andre-i/mini_weather/espSensors/notes.txt

08.02.18

1)  сменил датчикаи , теперь дс - эталонный для температур ,а показания даю с бмп-шки.
