andre-i/mini_weather/pict/forecast_ru.png

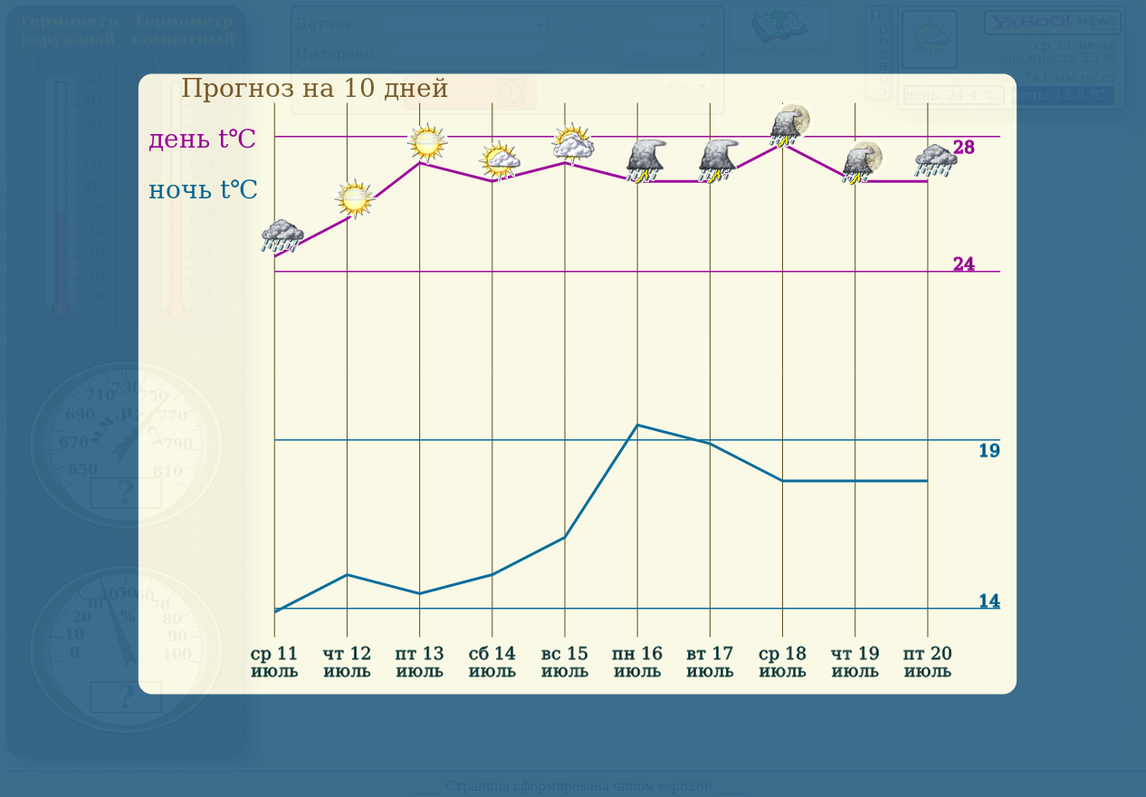
pict/forecast_ru.png
