andre-i/mini_weather/pict/IMG_20180507_144934.jpg

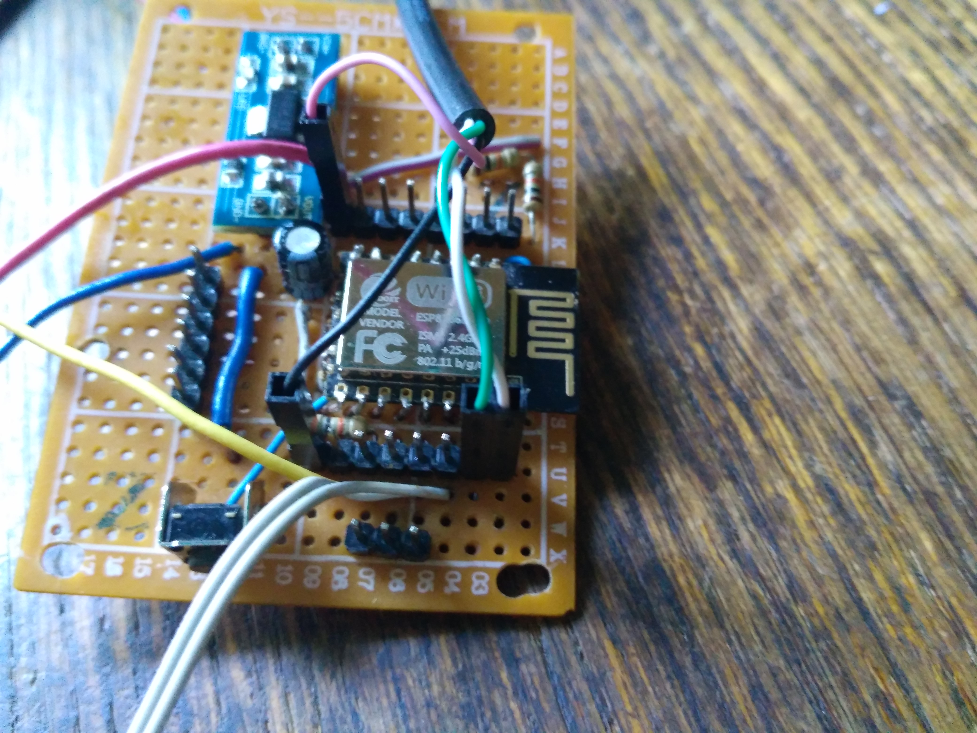
pict/IMG_20180507_144934.jpg
