andre-i/mini_weather/pict/view_ru.png

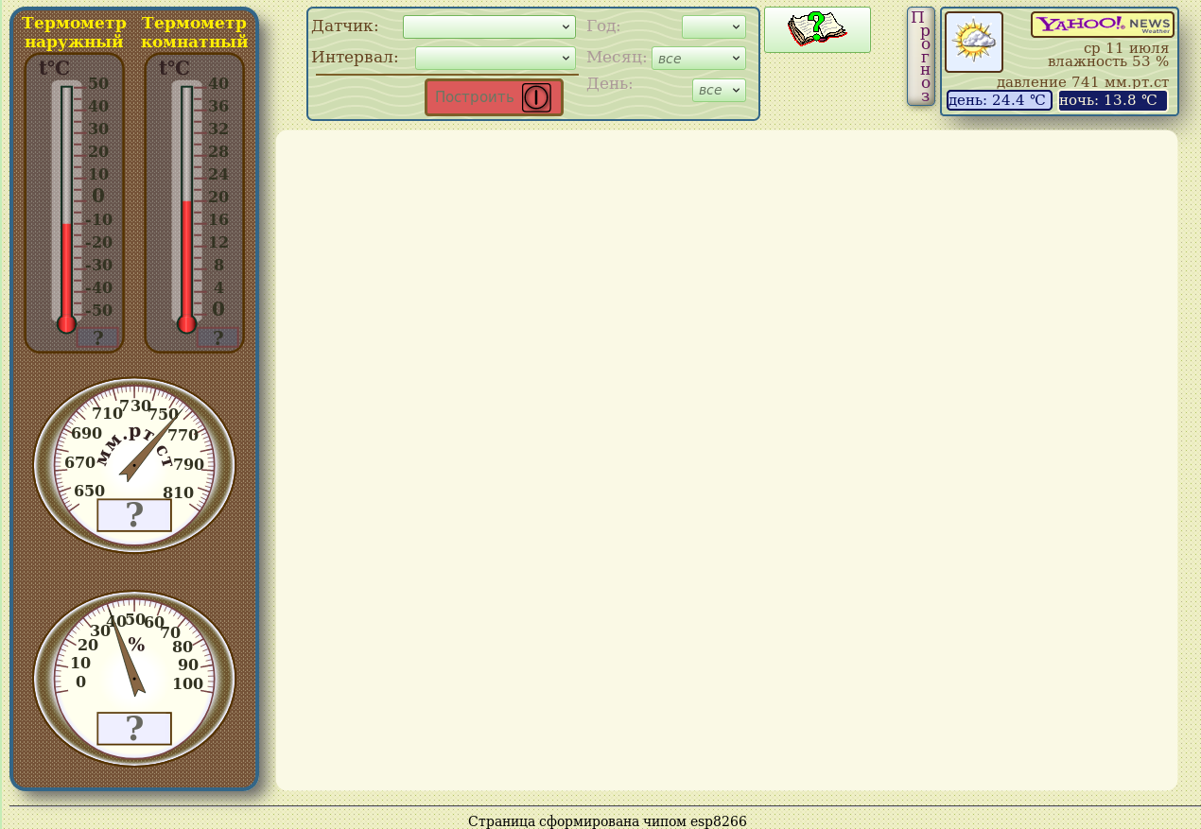
pict/view_ru.png
