andre-i/mini_weather/espSensors/Sensors.cpp

#include "Sensors.h"

extern bool LOG;

//  =========== PUBLIC ==================

/** set class variables for sensors */
Sensors::Sensors(uint8_t wBus, int dhtType) {
  for (int i = 0; i < maxCounterNumber ; i++) {
    allIn[i] = allOut[i] = allBaro[i] = allHumid[i] = "-100";
  }
  tIn = tOut = baro = humid = DEVICE_DISCONNECTED_C;
  mediaIn = mediaOut = mediaBaro = mediaHumid = 0;
  oneWire = new OneWire(wBus);
  dht = new DHT(wBus, dhtType);
  bme = new Adafruit_BMP280();
}

/** Try prepare sensors  on success return 0*/
int Sensors::init(Util *u) {
  int exitCode = 0;
  maxCounterNumber = REQUEST_COUNT - 1;
  // ds18b20
  dsMode = u->getDS18B20Mode();
  if (dsMode)sensors = new DallasTemperature(oneWire);
  if (dsMode)sensors->begin();
  if (dsMode)Serial.println("Init ds18b20");
  // DHT
  dht->begin();
  delay(1000);
  Serial.print("Start DHT .");
  delay(1000);
  Serial.print(".");
  delay(1000);
  Serial.println(".  ");
  if(!checkDHT()){
    exitCode += 1;
  }
  //  BMP 280
  if (!bme->begin(0x76)) {
    Serial.println("\n\tERROR BMP280  !");
    exitCode +=2;
  } else {
    if (LOG)Serial.println("Init BMP280");
  }
  return exitCode;
}

//  request sensors, compute media , fill arrays of values

// ds 18B20 purpose comparison with themperature other sensors
void Sensors::readDS18B20() {
  if (dsMode) {
    //if (++lastDS18B20 > maxCounterNumber)lastDS18B20 = 0;
    sensors->requestTemperatures(); // Send the command to get temperatures
    dsTemp = (int)(sensors->getTempCByIndex(0) * 10 + 0.5) / 10;
    Serial.print("DS18B20 t=");
    Serial.println(dsTemp);
  }
}

bool Sensors::checkDHT(){
  int t =  (int)(dht->readTemperature() + 0.5);
  int h = (int)(dht->readHumidity() + 0.5);
  if(isnan(t) || isnan(h))return false;
  if(h < 0 || h > 100) return false;
  if(t < -4 || t > 100) return false;
  return true;
}

void Sensors::readDHT() {
  if (++lastDHT > maxCounterNumber)lastDHT = 0;
  tIn = (int)(dht->readTemperature() + 0.5) + shiftThemperatureDHT;
  humid = (int)(dht->readHumidity() + 0.5);
  if ( isnan(tIn) || isnan(humid)) {
    if (LOG)Serial.println("Can`t read DHT sensor data");
    tIn = humid = DEVICE_DISCONNECTED_C;
  }
  allIn[lastDHT] = String(tIn);
  allHumid[lastDHT] = String(humid);
  if (lastDHT == 0) {
    mediaIn = tIn;
    mediaHumid = humid;
  } else {
    mediaIn = (int)((mediaIn + tIn) / 2 + 0.5);
    mediaHumid = (int) ((mediaHumid + humid) / 2 + 0.5);
  }
}

void Sensors::readBMP280() {
  if (++lastBMP280 > maxCounterNumber) lastBMP280 = 0;
  baro = (int)(bme->readPressure() / 133.32239F + 0.5);
  allBaro[lastBMP280] = String(baro);
  if (lastBMP280 == 0)mediaBaro = baro;
  else mediaBaro = (int)((mediaBaro + baro) / 2 + 0.5);
  tOut = bme->readTemperature() + shiftThemperatureBMP;
  allOut[lastBMP280] = String(tOut);
  if (lastBMP280 == 0)mediaOut = tOut;
  else mediaOut = (int)((mediaOut + tOut) / 2 + 0.5);

}



//  get sensors values
void Sensors::makeCurrentToJSON() {
  currentInJSON = String("{ \"tIn\":") + String(tIn) + String(", \"tOut\":") + String(tOut) +
                  String(", \"baro\":") + String(baro) + String(", \"humid\":") + String(humid) + String(" }");
}

String Sensors::getCurrentAsJSON() {
  if (LOG) {
    Serial.print("\"getCurrentAsJSON\": ");
    Serial.print(currentInJSON);
    String res = " [ BMP280 t= " + String(tOut);
    if(dsMode) res += " Dallas t= " + String(dsTemp);
    res += " ]";
    Serial.println(res);
  }
  return currentInJSON;
}


String Sensors::getLastAsJSON(String dataType) {
  String *type;
  int len = maxCounterNumber, last ;
  String res = "{ \"" + dataType + "\" : [ ";
  if (dataType == T_IN ) {
    type = allIn;
    last = lastDHT;
  }
  else if (dataType == HUMID) {
    type = allHumid;
    last = lastDHT;
  }
  else if (dataType == T_OUT) {
    type = allOut;
    last = lastBMP280;
  }
  else if (dataType == BARO) {
    type = allBaro;
    last = lastBMP280;
  }
  else {
    res = (String("{ \"ERROR\":[\"Not have sensors for ") + String(dataType) + String(", \" \" ], \"last\":0 }")) ;
    len = 0;
  }
  if ( len > 0 ) {
    for ( int i = 0; i < len; i++) {
      res += *(type + i) + ", ";
    }
    res += *(type + len) + "], \"last\": " + String(last) + " }";
  }
  if (LOG) {
    Serial.print("\"getLastAsJSON return: ");
    Serial.println(res);
    Serial.println("------------\n");
  }
  return res;
}

//
// get sensors values as Integer
//
int  Sensors::getT_In(){
  return tIn;
}
int  Sensors::getT_Out(){
  return tOut;
}
int  Sensors::getHumid(){
  return humid;
}
int  Sensors::getBaro(){
  return baro;
}

int Sensors::getMedia(String dataType) {
  if (dataType == T_IN)return mediaIn;
  if (dataType == T_OUT)return mediaOut;
  if (dataType == BARO) return mediaBaro;
  if (dataType == HUMID)return mediaHumid;
  return  DEVICE_DISCONNECTED_C;
}

void Sensors::getState(){
  Serial.println("Call Sensors::getState()");
}

// ============= PRIVATE ===================
