andre-i/mini_weather/espSensors/SerialHandler.cpp

#include "SerialHandler.h"

extern bool LOG;
extern bool DEBUG;

SerialHandler ::SerialHandler(Util *u) {
  util = u;
}

void SerialHandler::setFSstate( bool fsState) {
  isFS = fsState;
}

void SerialHandler::showFile(char answ[]) {
  String fName = answ;
  fName = fName.substring(2, fName.length());
  File file = SPIFFS.open(fName.c_str(), "r");
  if (!file) {
    Serial.print("Can`t open file: ");
    Serial.println(fName);
    Dir dir = SPIFFS.openDir(fName.c_str());
    String content = "";
    while (dir.next()) {
      content += "\t" + dir.fileName() + "\t";
      File f = dir.openFile("r");
      content += String(f.size()) + "\n";
      f.close();
      delay(60);
    }
    if (content.length() > 1) {
      Serial.println("File is directory it contains:");
      Serial.println(content);
    }
    return;
  } else {
    Serial.println("\t______ file content : ____");
    while (file.available())Serial.write(file.read());
    Serial.println("\n\t  ________   EOF  _______  ");
    file.close();
  }
}

void SerialHandler::showManual(const char* lang) {
  const char *help = (strncmp(lang, "ru", 2) == 0) ? help_ru : help_en;
  char ch = *help;
  int i = 0;
  while (ch != '\0') {
    if (ch == '\n') {
      Serial.println("");
      delay(10);
    }
    else Serial.print(ch);
    ch = *(help++);
  }
}

void SerialHandler::handle(void) {
  char answ[100];
  int i = 0;
  delay(20);
  while (Serial.available() > 0) {
    answ[i] = Serial.read();
    i++;
    delay(20);
  }
  answ[i] = '\0';
  //set start parameters
  if (isSetParam) {
    setParameter(answ);
    // append to file
  } else if (isAppend) {
    append(answ);
  } else {
    // show manual and toggle log out state
    if (i < 3) {
      if (answ[0] == 'e' && answ[1] == 'n') {
        showManual("en");
      } else if (answ[0] == 'r' && answ[1] == 'u') {
        showManual("ru");
      } else if (answ[0] == 'y' || answ[0]  == 'Y') {
        LOG = true;
        Serial.println(" ON LOG output!");
      } else if (answ[0] == 'n' || answ[0] == 'N') {
        LOG = false;
        Serial.println(" OFF LOG output!");
      } else if (answ[0] == 's' && answ[1] == 'i') {
        Serial.println(util->fsINFO());
      }
    } else {
      executeCommand(answ);
    }
  }
}

void SerialHandler::executeCommand(char answ[100]) {
  //  read from file system
  if (answ[0] == 'r' && answ[1] == '_') {
    if (isFS)showFile(answ);
    else Serial.println("WARNING: Can`t access to file system");
    return;
  }
  // write or add content by file
  if ((answ[0] == 'a' || answ[0] == 'w') && answ[1] == '_') {
    if (isFS)writeToFile(answ);
    else Serial.println("WARNING: Can`t access to file system");
    return;
  }
  // set debug mode on worked app
  if ( strncmp(answ, "debug", 5) == 0) {
    Serial.println(setDebug(String(answ).substring(5)));
  }
  // get date-time on module
  if (strncmp(answ, "time", 4) == 0) {
    Serial.print("Now on module  ");
    Serial.println(util->getFullDate());
  }
  if (strncmp(answ, "restart", 6) == 0) {
    Serial.println(" Try restart chip!!!");
    ESP.restart();
  }
  // get current work parameters
  if (strncmp(answ, "curr", 4) == 0) {
    Serial.println("  ------- Current application parameters -------");
    Serial.println(util->getCurrentProps());
    Serial.println("  ___________  end current parameters  _________\n");
  }

  //  set date-time
  if (strncmp(answ, "date", 4) == 0 ) {
    if (!isFS) Serial.println("Fail set date-time (No get access on file system)");
    if (util->assignTime(answ + 5)) {
      String mess = "(Ok) Success set date-time: " + util->getYear() + "/" + util->getMonth() + "/" + util->getDay() + " " + util->getHour() + "h";
      Serial.println(mess);
    } else {
      Serial.println("(No) Fail set Date-time WRONG FORMAT");
    }
  }
  //     PROPERTIES FILE
  // write start wifi params to PROPS_FILE
  // bulk fill the properties file
  if ( strncmp(answ, "fillParam", 7) == 0) {
    if (isFS)fillStartParameters();
    else Serial.println("WARNING: Can`t access to file system");
  }
}

bool SerialHandler::writeToFile(char req[]) {
  String all = req;
  // for write
  int ind = all.indexOf("=");
  // for append
  if (req[0] == 'a')ind = all.length();
  if (ind < 1) {
    Serial.println("Error: bad request format, it must contain \"=\"(equals sign) !");
    return false;
  }
  String fName = all.substring(2, ind);
  String toWrite = all.substring(++ind);
  if (req[0] == 'a') {
    toAppend = SPIFFS.open(fName, "a");
    if (toAppend) {
      Serial.print(" Start append to file: ");
      Serial.println(fName);
      Serial.println("For get to new line enter '%%', for end of append enter '##$");
      Serial.println("Для перехода на новую строку вводить '%%', для завершения записи ввести'##$'\n");
      toAppend.print("");
      isAppend = true;
      return true;
    } else {
      Serial.print("ERROR [ Can`t open file '");
      Serial.print(fName);
      Serial.println("' for append ] ");
      return false;
    }
  } else {
    return write(fName, toWrite);
  }

}

bool SerialHandler::write( String fName, String toWrite) {
  File file = SPIFFS.open(fName, "w");
  if (file) {
    Serial.print("Write to File: ");
    Serial.println(fName);
    if (toWrite.length() < 1) {
      file.close();
      SPIFFS.remove(fName);
      Serial.print(" Delete file: ");
      Serial.println(fName);
      return true;
    }
    file.print(toWrite.c_str());
    file.close();
    Serial.println(toWrite);
    Serial.println("  ______  success write and closed file ________  ");
    return true;
  } else {
    Serial.print( "Can`t write to file: ");
    Serial.println(fName);
    return false;
  }
}

/**
   str - char sequence for append to file
   return 0 if success
*/
int SerialHandler::append(char* str) {
  if (!toAppend) {
    Serial.println("ERROR: can`t append line to empty file");
    isAppend = false;
    return 1;
  } else if (str[0] == '#' && str[1] == '#' && str[2] == '$') {
    toAppend.flush();
    toAppend.close();
    Serial.println( "\n\t ____  end append  ____");
    isAppend = false;
  } else if (str[0] == '%' && str[1] == '%') {
    toAppend.println("");
    Serial.println("");
  } else {
    toAppend.print(str);
    Serial.print(str);
  }
  return 0;
}

/*
  // ================= set DEBUG MODE ================
*/
String SerialHandler::setDebug(String mode) {
  String res = " DEBUG ";
  mode.trim();
  if (mode.equals("y") || mode.equals("Y")) {
    res += "ON";
    DEBUG = true;
    LOG = true;
  } else {
    res += "OFF";
    DEBUG = false;
    LOG = false;
  }
  return res;
}

//
// ============================  properties file  ==========================
//


void SerialHandler::writeToPropFile( struct params par) {
  File file = SPIFFS.open(PROPS_FILE, "w");
  if (!file) {
    Serial.println("WARNING: Can`t access to fileSystem, WiFi properties do not written!");
  }
  String res = "## property file contain properties for Wi-Fi in AP and STA mode\n";
  res += "# ONLY_STA mode( if  'true' chip work only as STA)\n";
  if (par.only_sta && par.only_sta.length() > 0 ) res += String(ONLY_STA) + " " + par.only_sta + "\n";
  res += "# AP network interface address\n";
  if (par.ap_network && par.ap_network.length() > 0) res += String(AP_NETWORK_ADDRESS) + " " + par.ap_network + "\n";
  res += "# AP mode\n";
  if (par.ap_ssid && par.ap_ssid.length() > 2)res += String(AP_SSID) + " " + par.ap_ssid + "\n";
  if (par.ap_passwd && par.ap_passwd.length() > 6)res += String(AP_PASSWD) + " " + par.ap_passwd + "\n";
  if (par.ap_ip && par.ap_ip.length() > 6)res += String(AP_IP) + " " + par.ap_ip + "\n";
  res += "# STA mode\n";
  if (par.sta_ssid && par.sta_ssid.length() > 2)res += String(STA_SSID) + " " + par.sta_ssid + "\n";
  if (par.sta_passwd && par.sta_passwd.length() > 6)res += String(STA_PASSWD) + " " + par.sta_passwd + "\n";
  res += "# thingspeak write API key\n";
  if (par.ts_api_key && par.ts_api_key.length() > 15)res += String(THINGSPEAK_KEY) + " " + par.ts_api_key + "\n";
  res += "# dDS18B20 mode\n";
  if (par.ds18b20_mode && par.ds18b20_mode.length() > 3) res += String(DS18B20_MODE) + " " + par.ds18b20_mode + "\n";
  res += "# debug mode\n";
  if (par.isDebug && par.isDebug.length() > 3)res += String(DEBUG_MODE) + " " + par.isDebug + "\n";
  file.print( res.c_str());
  file.close();
  Serial.println("Success write parameters to property file");
  util->writeLog(String(util->getDay()) + "/" + String(util->getMonth()) + "/" + String(util->getYear()) + " - writen new properties ");
}

//
//  ======== bulk write start parameters ==========
//

/*
    Start write all parameters to props.txt file
*/
void SerialHandler::fillStartParameters() {
  isSetParam = true;
  // prepare structure with default values
  newParams.only_sta = "false";
  newParams.ap_network = "";
  newParams.ap_ssid = "";
  newParams.ap_passwd = "";
  newParams.ap_ip = "192.168.0.1";
  newParams.sta_ssid = "";
  newParams.sta_passwd = "";
  newParams.ts_api_key = "";
  newParams.isDebug = "false";
  Serial.println(" Start set parameters !");
  Serial.println(" Установка параметров  запуска.");
  Serial.println("If some parameter be empty string, then it NO WRITE");
  Serial.println("Пустые значения допускаются, но не записываются!");
  Serial.println("AP ssid, AP password, AP_IP - is mandatory. Other may be empty");
  Serial.println("Если only_sta установлено в 'false' поля AP ssid, AP password, AP_IP - обязательны для заполнения, остальные нет");
  Serial.print("    WI-FI\n\n wifi mode|режим вай-фай true|false \n  if 'true' work only as STA | при 'true' только клиент   ONLY_STA ?  " );
  parName = ONLY_STA;
}


void SerialHandler::setParameter(char* value) {
  String res = value;
  res.trim();
  if (strncmp(parName, ONLY_STA, 2) == 0) {
    newParams.only_sta = res;
    res =  " = " + res + "\n AP network interface address(адрес сетевого интерфейса точки доступа)\n need if ONLY_STA - true( нужен, если чип работает только как клиент(ONLY_STA=true)\n  apAddress ? ";
    parName = AP_NETWORK_ADDRESS;
    Serial.println(res);
  } else if (strncmp(parName, AP_NETWORK_ADDRESS, 2) == 0) {
    newParams.ap_network = res;
    res = " = " + res + "\nAP(Точка доступа)\nssid(имя сети) ?  ";
    parName = AP_SSID;
    Serial.println(res);
  } else if (strncmp(parName, AP_SSID, 2) == 0) {
    newParams.ap_ssid = res;
    res = " = " + res + "\npassword(пароль)?  ";
    parName = AP_PASSWD;
    Serial.print(res);
  } else if (strncmp(parName, AP_PASSWD, 2) == 0) {
    newParams.ap_passwd = res;
    res = " = " + res + "\nAP_IP(адрес сети)?  ";
    parName = AP_IP;
    Serial.print(res);
  } else  if (strncmp(parName, AP_IP, 2) == 0) {
    newParams.ap_ip = res;
    res = " = " + res + "\n\n  STA\nssid(имя сети)?  ";
    parName = STA_SSID;
    Serial.print(res);
  } else if (strncmp(parName, STA_SSID, 2) == 0) {
    newParams.sta_ssid = res;
    res = " = " + res + "\npassword(пароль)?  ";
    parName = STA_PASSWD;
    Serial.print(res);
  } else if (strncmp(parName, STA_PASSWD, 2) == 0) {
    newParams.sta_passwd = res;
    res = " = " + res + "\n\nthingspeak key(ключ для записи на thingspeak)?  ";
    parName = THINGSPEAK_KEY;
    Serial.print(res);
  } else if (strncmp(parName, THINGSPEAK_KEY, 2) == 0) {
    newParams.ts_api_key = res;
    res = " = " + res + "\n\nDS18B20 mode(включать ли DS18B20 true|false?  При true - включать ";
    parName = DS18B20_MODE;
    Serial.print(res);
  } else if (strncmp(parName, DS18B20_MODE, 2) == 0) {
    newParams.ds18b20_mode = res;
    res = " = " + res + "\n\ndebug(отладка) true|false?  ";
    parName = DEBUG_MODE;
    Serial.print(res);
  } else if (strncmp(parName, DEBUG_MODE, 2) == 0) {
    newParams.isDebug = res;
    parName = "ends_of_params";
    showSummary();
  } else if (res.equals("y")) {
    writeToPropFile(newParams);
    isSetParam = false;
  } else if (res.length() == 1)isSetParam = false;
}

void SerialHandler::showSummary() {
  Serial.println("");
  Serial.println("I have for write parameters:");
  Serial.println("Значения параметров для записи:");
  Serial.print("\nonly_sta =");
  Serial.print(newParams.only_sta);
  Serial.print("\nAP (точка доступа)  ssid=");
  Serial.print(newParams.ap_ssid);
  Serial.print("  password=");
  Serial.print(newParams.ap_passwd);
  Serial.print(" AP IP=");
  Serial.print(newParams.ap_ip);
  Serial.print("\nSTA (клиент)  ssid=");
  Serial.print(newParams.sta_ssid);
  Serial.print("  password=");
  Serial.print(newParams.sta_passwd);
  Serial.print("\nthingspeak key=");
  Serial.print(newParams.ts_api_key);
  Serial.print("\nDS18B20 mode=");
  Serial.print(newParams.ds18b20_mode);
  Serial.print("\ndebug=");
  Serial.print(newParams.isDebug);
  Serial.print("\n  Write it(Записать)   y|n? (y - записать, любое другое - не записывать)\n");
}
