andre-i/mini_weather/(commit log)

2018-02-08 1. change source tOut: old-ds18b20 new-bmp280 2. in test.js get sensor data from object "sensors"
2018-03-05 fix write frequency in debug mode
    [Util.cpp, espSensors.ino]
2018-04-04 fix draw Year chert bug
    [espSensors.ino]
2018-05-11 add led support
2018-06-01 js fix bug with short names
    [Sensors.cpp, SerialHandler.cpp, SerialHandler.h, props.h]
2018-06-01 fix bug
    in setParameter add out with ds18b20 param value
    [SerialHandler.cpp]
2018-07-10 add schematic
2018-07-11 edit props.h
2018-07-12 add the shift values for sensors themperature
2018-07-13 relace schematic
2018-09-25 remake every days reboot
    [Util.cpp, Util.h]
